bfMendonca/radar-cam-recorder/hardware/pizero-radar-cam-testplate.stl

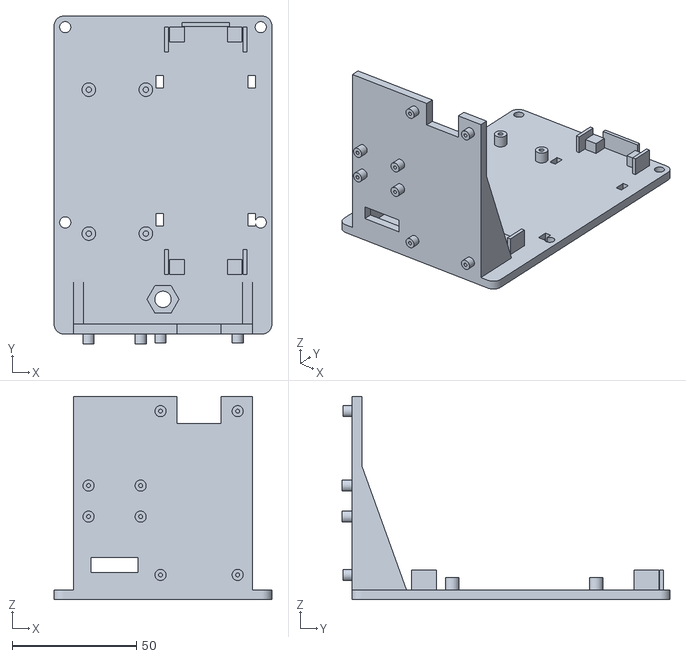
[picture p3: CAD file, 2026-10-24]
hardware/pizero-radar-cam-testplate.stl
87.8 x 132.2 x 82.0
