bfMendonca/radar-cam-recorder/(commit log)

2026-10-20 Add design for radar-cam-recorder
    Design for the camera + LD2451 radar recorder on the Pi Zero W:
    synced timestamps, segmented crash-safe files, free-space policy,
    graceful shutdown, systemd service, status bus, session reader.
2026-10-20 Add implementation plan for radar-cam-recorder
    Twelve TDD tasks from the approved design: config, clocks, storage,
    status bus, sessions, radar, camera, supervisor (lifecycle, then
    failures), reader, CLI/systemd, and Pi acceptance checks.
2026-10-21 build: pin mypy<1.20 and Python 3.9 venv for a warning-free mypy run
2026-10-21 feat: rpicam and fake camera sources
2026-10-21 feat: disk policy, degraded mode and device recovery
2026-10-21 fix: camera state follows the run, same-segment retries, session counter self-heals
2026-10-21 fix: camera retry never reuses a segment that has video
2026-10-21 feat: camera stall watchdog
2026-10-21 docs: Pi uv Python, boot-time camera note, stall watchdog
2026-10-21 fix(reader): prefer metadata over a stale frames CSV, keep split reports
    A frames.csv with fewer rows than its segment's metadata is stale (C1):
    the reader then uses the metadata. One FrameDecoder is fed across a
    session's radar segments, so a report split across a rotation is kept,
    and a garbled radar line is skipped instead of dropping the rest of the
    segment.
2026-10-21 fix(recovery): regenerate a stale frames CSV
    Recovery used to skip any segment that already had frames.csv. A reused
    segment could keep the 0-row CSV of the run that left it empty while its
    metadata later held minutes of frames (C1). Recovery now rewrites a
    frames.csv that has fewer rows than the metadata has frames; one with at
    least as many rows is left alone, so a rewrite never loses rows.
2026-10-21 fix(supervisor): rotation order, fsync, frame drops, lazy recovery
    - C1: starting a camera run deletes the segment's frames CSV (and .tmp),
    so a reused segment never keeps the 0-row CSV of the run that left it
    empty.
    - I1: a rotation stops the old run, starts the new one, then writes the
    old segment's frames CSV; segment boundaries come from the clock after
    the stop, the stall grace from the clock after the start returns, and
    the tick re-reads the clock after a rotation or a session open.
    - I2: after a run stops, its .h264, .meta.json, .pts.txt and the video
    dir are fsynced (best effort, failures logged).
    - I3: each closed segment records drops (intervals above 1.5 frame
    period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
2026-10-21 docs: measured rotation gap, clocks, frame_at latency, acceptance 7
    README: rotation gap re-measured on the Pi (26 x 300 s rotations, median
    3.0 s, 2.5-3.8 s); radar t_rx_ns is CLOCK_BOOTTIME and the camera
    SensorTimestamp the kernel frame timestamp; frame_at() callers subtract
    radar_latency_ns; per-segment drops/max_gap_ns. pi-acceptance: acceptance
    7 expects a state event plus one "radar silent" incident.
2026-10-21 docs: design for status LEDs and button
2026-10-21 docs: implementation plan for status LEDs and button
2026-10-21 deploy: kernel LED/button setup and spike findings
2026-10-21 config: [control] and [leds] tables
2026-10-21 button: gesture classifier and evdev reader
2026-10-21 button: never lose a release inside the debounce window; deterministic reader tests
2026-10-21 leds: state patterns, sysfs output, LED sink
2026-10-21 leds: hold rejected flash for two blinks
2026-10-21 leds: ignore flashes after long_armed, bound sysfs permission retries
2026-10-21 cli: LEDs, button, signals and systemd watchdog
2026-10-21 leds: blink on stopped; heartbeat during startup recovery
2026-10-21 docs: LEDs and button install and acceptance
2026-10-21 docs: fix round 1 for LEDs and button docs
2026-10-22 supervisor: a crash ends in error, not stopped; stop reason 'stopped by command'
    A crash inside run() now closes the session complete, publishes ERROR with the
    crash reason and re-raises, so the next start sees an unclean status file and
    warns. Toggle stop records 'stopped by command' (button or SIGUSR2). Tests for a
    split whose new session fails to open. Document the radar progress coupling to
    check_interval_s.
2026-10-22 leds: rewrite after a failed write; long_armed overlay times out
    A failed sysfs write forgets the last pattern so the next show() is not skipped.
    The long_armed red fast blink clears with a warning if the process is still
    alive 10 s after arming. Drop an unreachable STOPPING branch.
2026-10-22 config: record at start by default; docs for idle mode and checks
    start_mode defaults to "record" again; "idle" is the option for button-driven
    use. README/CHANGELOG drop the starts-idle behaviour change. Acceptance check 7
    exercises missing devices through the config; radar progress note.
2026-10-24 hardware: add the 3D-printed Pi Zero radar/camera test plate
2026-10-24 fix(packaging): include the radar_cam_recorder.camera subpackage
    Non-editable installs only shipped the top-level package, so
    'from radar_cam_recorder.reader import open_session' failed with
    ModuleNotFoundError: radar_cam_recorder.camera.
2026-10-24 ci: pin the matrix Python for uv run too
    uv run followed .python-version and rebuilt the venv on 3.9 without
    pytest-cov, so every 3.10+ job failed with 'unrecognized arguments: --cov'.
2026-10-31 feat: optional I2C RTC support; move the button to GPIO 22
    The RTC needs I2C on GPIO 2/3, so the button moves from GPIO 3 to GPIO 22
    (pin 15). The input device is now button@16: gpio-keys names it after the
    GPIO number in hex. The button no longer wakes a halted Pi.
    - deploy/config.txt.rtc.snippet enables i2c_arm and the i2c-rtc overlay.
    - session.json records rtc (driver, time, offset from the system clock) and
    wall_clock_source ("ntp", "rtc" or "unsynced") at session start. Additive;
    format_version stays 1.
    - README: wiring, RTC setup and the new fields.
